Tomacbe/armoire-cles-rixensart/mecanique/presse_etoupe_contre_ecrou.stl

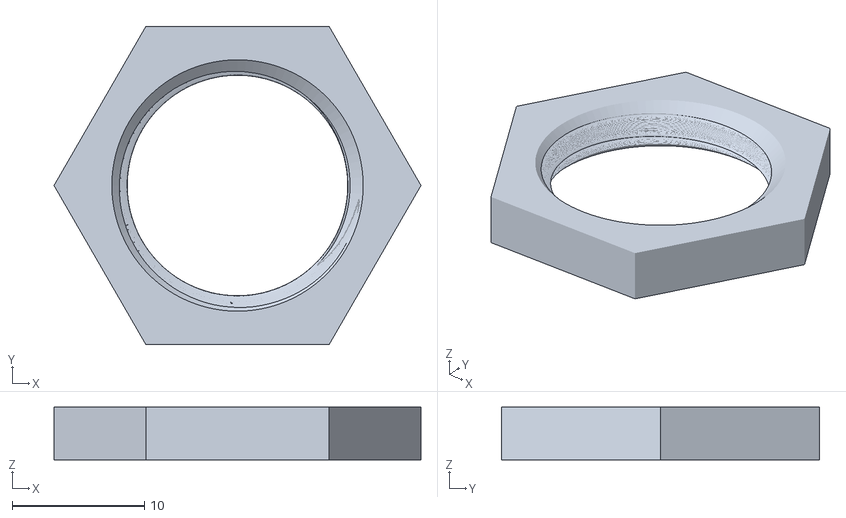
[picture p10: CAD file, 2026-11-03]
mecanique/presse_etoupe_contre_ecrou.stl
27.7 x 24.0 x 4.00
