Tomacbe/armoire-cles-rixensart/mecanique/presse_etoupe_ecrou_chapeau.stl

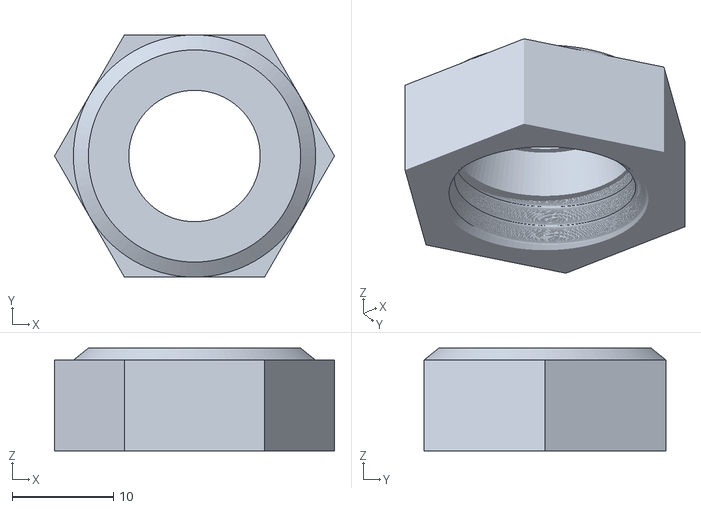
[picture p11: CAD file, 2026-11-03]
mecanique/presse_etoupe_ecrou_chapeau.stl
27.7 x 24.0 x 10.2
