Tomacbe/armoire-cles-rixensart/mecanique/presse_etoupe_corps.stl

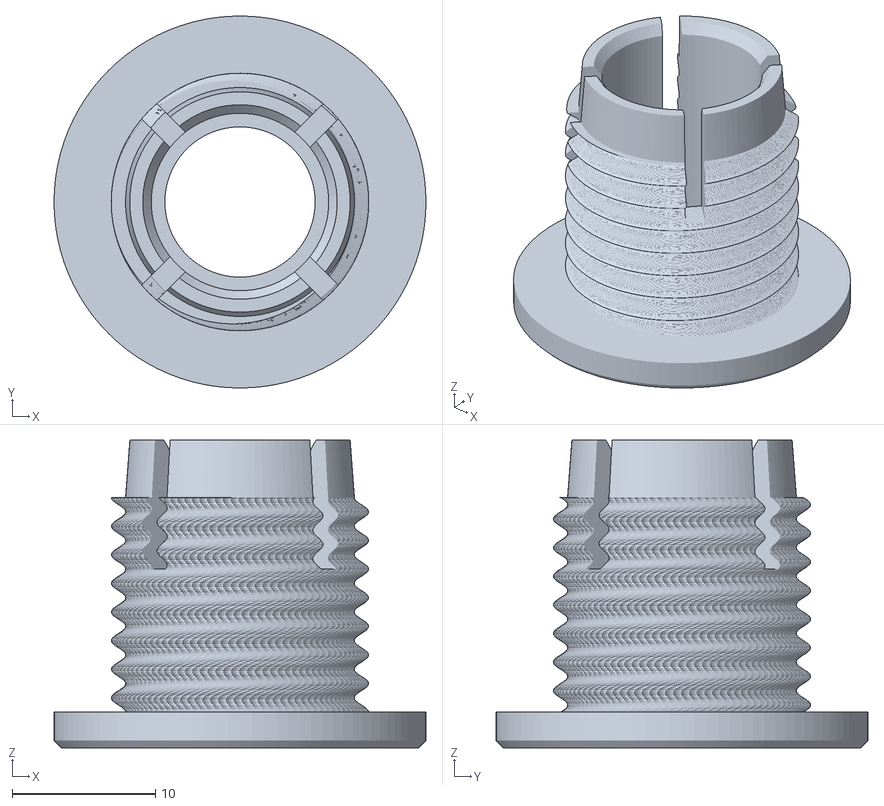
[picture p12: CAD file, 2026-11-03]
mecanique/presse_etoupe_corps.stl
26.0 x 26.0 x 21.5
