Tomacbe/armoire-cles-rixensart/docs/schema/schema_cablage_armoire.pdf

PS1

## ALIM 12 V

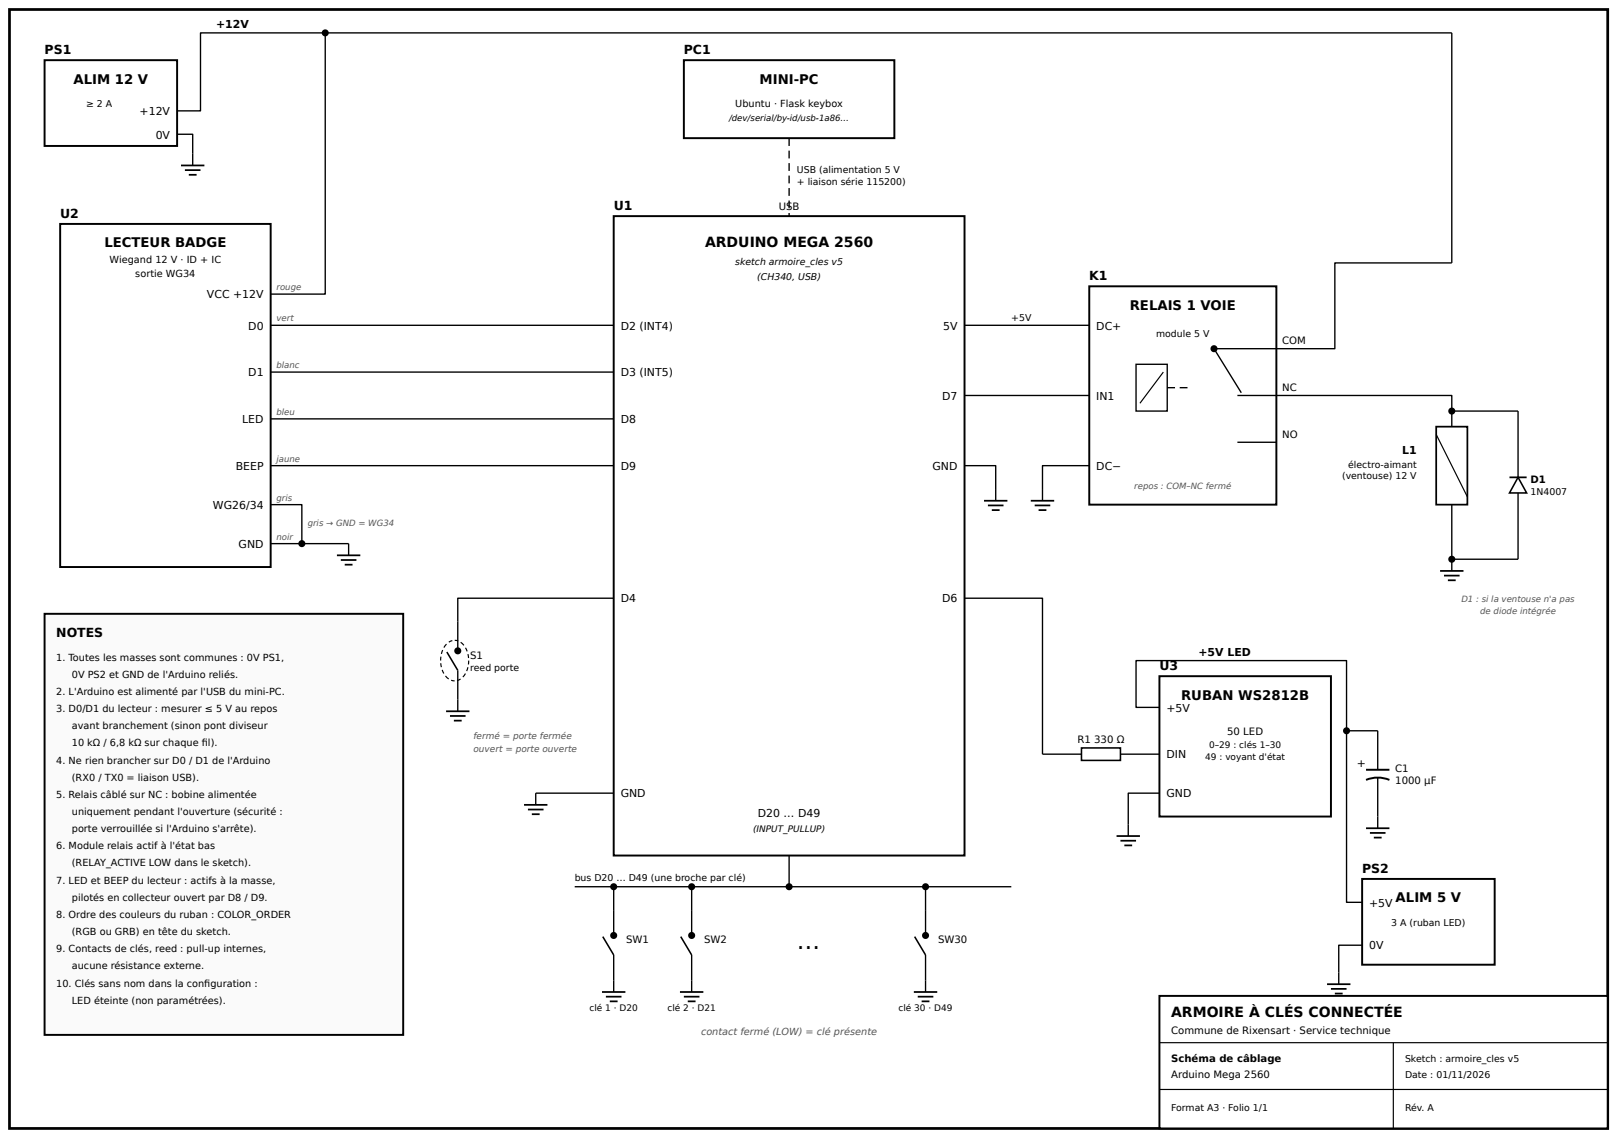
[picture p13: page 1]

Ubuntu · Flask keybox
/dev/serial/by-id/usb-1a86…

repos : COM–NC fermé

D1 : si la ventouse n'a pas
de diode intégrée

1. Toutes les masses sont communes : 0V PS1,
0V PS2 et GND de l'Arduino reliés.
2. L'Arduino est alimenté par l'USB du mini-PC.
3. D0/D1 du lecteur : mesurer ≤ 5 V au repos
avant branchement (sinon pont diviseur
10 kΩ / 6,8 kΩ sur chaque fil).
4. Ne rien brancher sur D0 / D1 de l'Arduino
(RX0 / TX0 = liaison USB).
5. Relais câblé sur NC : bobine alimentée
uniquement pendant l'ouverture (sécurité :
porte verrouillée si l'Arduino s'arrête).
6. Module relais actif à l'état bas
(RELAY_ACTIVE LOW dans le sketch).
7. LED et BEEP du lecteur : actifs à la masse,
pilotés en collecteur ouvert par D8 / D9.
8. Ordre des couleurs du ruban : COLOR_ORDER
(RGB ou GRB) en tête du sketch.
9. Contacts de clés, reed : pull-up internes,
aucune résistance externe.
10. Clés sans nom dans la configuration :
LED éteinte (non paramétrées).

bus D20 … D49 (une broche par clé)

ARMOIRE À CLÉS CONNECTÉE
Commune de Rixensart · Service technique

contact fermé (LOW) = clé présente
